nullstalgia/NullWiiCon/hardware/bootloader/Readme.txt

For Atmega32u4

Fuses:
---
low_fuses=0xff
high_fuses=0xd8
extended_fuses=0xcb
