nullstalgia/NullWiiCon/hardware/NullWiiCon v2/NullWiiCon v2.kicad_pcb

## KiCad design hardware/NullWiiCon v2/NullWiiCon v2.kicad_pcb (2020-03-04)

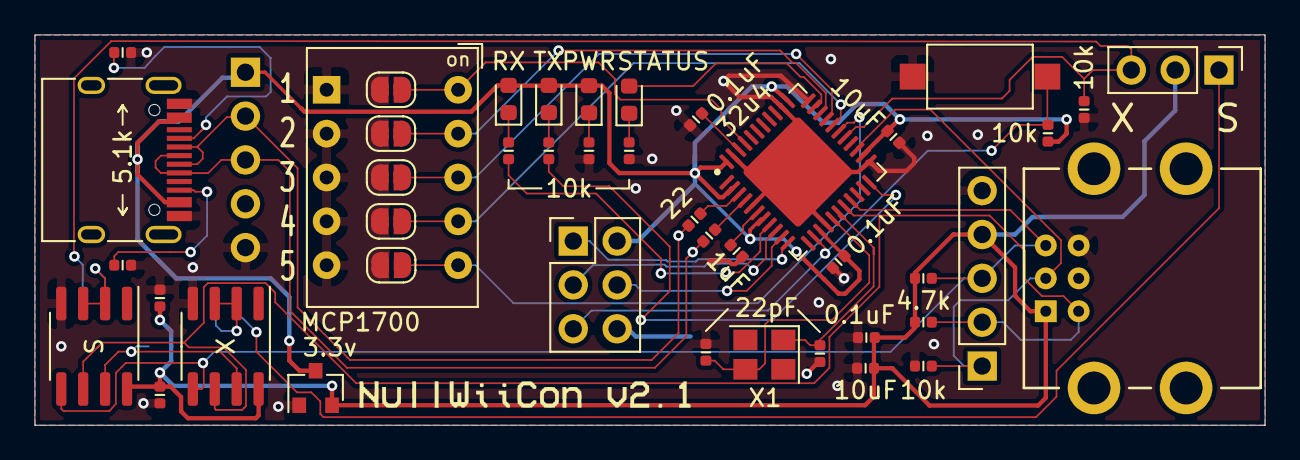
[picture p5: board NullWiiCon v2.kicad_pcb from above]

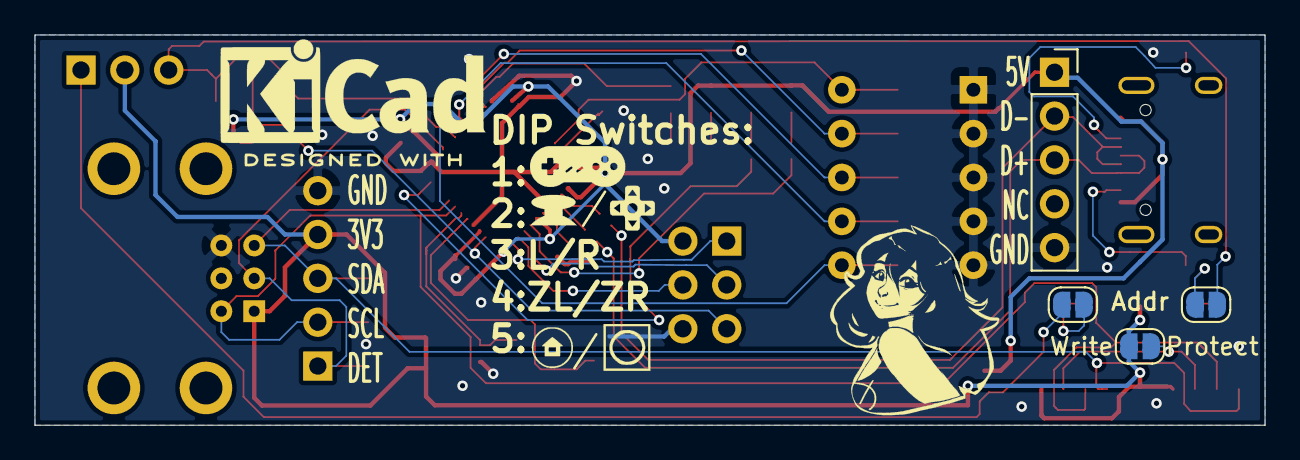
[picture p6: board NullWiiCon v2.kicad_pcb from below]

Board: 2 copper layers, 71.2 x 22.6 mm, 48 parts (4 on the bottom side), 37 nets.

Parts:
C1, C3, C9: 10uF; C_0402_1005Metric
C2, C4, C7, C10: 0.1uF; C_0402_1005Metric
C5, C6: 22pF; C_0402_1005Metric
C8: 1uF; C_0402_1005Metric
D1: PWR; LED_0603_1608Metric
D2: TX; LED_0603_1608Metric
D3: RX; LED_0603_1608Metric
D4: STATUS; LED_0603_1608Metric
J1: USB_C_Receptacle_USB2.0; USB_C_Receptacle_HRO_TYPE-C-31-M-12
J2, J4: Conn_01x05_Female; PinSocket_1x05_P2.54mm_Vertical
J5: Conn_02x03_Odd_Even; PinSocket_2x03_P2.54mm_Vertical_MIRROR
J6: Conn_01x03_Female; PinHeader_1x03_P2.54mm_Vertical
JP1, JP2, JP3, JP4, JP5, JP6, JP7, JP9: Jumper; SolderJumper-2_P1.3mm_Open_RoundedPad1.0x1.5mm
P1: CONN_WII
R1, R3, R5, R6, R11, R12, R13: 10k; R_0402_1005Metric
R2, R4: 5.1k; R_0402_1005Metric
R7, R8: 4.7k; R_0402_1005Metric
R9, R10: 22; R_0402_1005Metric
SW1: SW_Push; SW_SPST_CK_RS282G05A3
SW2: SW_DIP_x05; SW_DIP_SPSTx05_Slide_9.78x14.88mm_W7.62mm_P2.54mm
U1: MCP1700-3302E_SOT23; SOT-23
U2: ATmega32U4-MU; QFN-44-1EP_7x7mm_P0.5mm_EP5.2x5.2mm
U3, U4: CAT24C256; SOIC-8_3.9x4.9mm_P1.27mm
X1: Crystal_GND24_Small; Crystal_SMD_3225-4Pin_3.2x2.5mm

Connections:
+3V3: C3.1, C4.1, C9.1, C10.1, J2.4, J6.2, JP9.2, P1.1, R7.2, R8.2, U1.2, U3.8, U4.8
+5V: C1.1, C2.1, D1.2, D2.2, D3.2, J1.A4, J1.A9, J1.B4, J1.B9, J4.1, J5.2, R11.2, U1.3, U2.2, U2.7, U2.14, U2.24, U2.34, U2.44
/CC1: J1.A5, R2.2
/CC2: J1.B5, R4.1
/DETECT: J2.1, P1.3, R1.2, U2.25
/DIP_SW1: JP2.2, SW2.10, U2.41
/DIP_SW2: JP3.2, SW2.9, U2.31
/DIP_SW3: JP4.2, SW2.8, U2.30
/DIP_SW4: JP5.2, SW2.7, U2.29
/DIP_SW5: JP6.2, SW2.6, U2.28
/DN: J1.A7, J1.B7, J4.2, R10.2
/DP: J1.A6, J1.B6, J4.3, R9.2
/MISO: J5.1, U2.11
/MOSI: J5.4, U2.10
/RESET: J5.5, R11.1, SW1.1, U2.13
/RX_LED: R6.1, U2.8
/S: J6.1, JP7.1
/SCL: J2.2, P1.2, R7.1, U2.18, U3.6, U4.6
/SCLK: J5.3, U2.9
/SDA: J2.3, P1.5, R8.1, U2.19, U3.5, U4.5
/STATUS: D4.2, U2.32
/TX_LED: R5.1, U2.22
/WP: JP9.1, U3.7, U4.7
/X: J6.3, JP1.2, R12.1, U2.27
GND: C1.2, C2.2, C3.2, C4.2, C5.1, C6.1, C7.2, C8.2, C9.2, C10.2, J1.A1, J1.A12, J1.B1, J1.B12, J2.5, J4.5, J5.6, JP2.1, JP3.1, JP4.1, JP5.1, JP6.1, P1.6, R1.1, R2.1, R3.1, R4.2, R12.2, R13.1, SW1.2, SW2.1, SW2.2, SW2.3, SW2.4, SW2.5, U1.1, U2.5, U2.15, U2.23, U2.33, U2.35, U2.43, U2.45, U3.4, U4.4
unnamed: C5.2, U2.17, X1.1
unnamed: C6.2, U2.16, X1.3
unnamed: C7.1, U2.42
unnamed: C8.1, U2.6
unnamed: D1.1, R3.2
unnamed: D2.1, R5.2
unnamed: D3.1, R6.2
unnamed: D4.1, R13.2
unnamed: JP1.1, U4.2, U4.3
unnamed: JP7.2, U3.2, U3.3
unnamed: R9.1, U2.4
unnamed: R10.1, U2.3
