nullstalgia/NullWiiCon/(commit log)

2020-01-26 more suitable for copying straight to Arduino folder
2020-01-28 Clamp map() on switch
2020-02-16 Hardware, Bootloader, start of README
    [NullWiiCon v2.kicad_pcb, NullWiiCon v2.sch, NullWiiCon v2_Key Combo.kicad_pcb, NullWiiCon v2_Key Combo.sch]
2020-02-19 Huge Switch FW Update, move files around
    In Switch Mode, the Manu and Prod. is changed to Nullstalgia NullWiiCon. Still works on a Switch. Additionally, the stick will report an exact 0 position if it is within 2 of what it was when the sketch starts.
2020-02-21 Rename 'combo' to 'Slim'; more reasonable name
    [NullWiiCon v2_Slim.kicad_pcb, NullWiiCon v2_Slim.sch]
2020-03-04 Start of PCB 2.1
    [NullWiiCon v2.kicad_pcb, NullWiiCon v2.sch]
2020-03-04 PCB V2.1
    [NullWiiCon v2.kicad_pcb, NullWiiCon v2.sch, NullWiiCon v2_Slim.kicad_pcb, NullWiiCon v2_Slim.sch]
2020-07-10 Combine XInput and Horipad sketches to switchable descriptor
